Erik-k/StarJar/README.md

# StarJar
Radiation controlled Christmas lights.

For pictures and a thorough write-up, visit http://knek-tek.me/index.php/2018/01/09/radiation-controlled-christmas-lights/
