Erik-k/StarJar/BOM.xls

Source | H:/StarJar/StarJar.sch
Kicad Rev | Eeschema 4.0.6
Title | Radiation controlled Christmas lights
Company | K'NEK-TEK
Revision | 1.2
Date Issue | November 2017
Reference | Value
U1 | LM555N
J2 | Screw_Terminal_1x02
R10 | 220k
C3 | 1n
D2 | 1N914
R5 | 1k
R4 | 330
R1 | 100k
L1 | 10mH
Q5 | 2N3904
R9 | 15
RV2 | 10-ohm pot
D1 | 1N4937
C2 | 10n, 1kV
R2 | 4.7M
C4 | 220pF, 1kV
C5 | 1uF
RV1 | 500k POT
J3 | Geiger Muller Tube, SBM-20 or SBM-20U
Q4 | 2N3904
R8 | 100k
Q1 | JN3303
C1 | 4.7uF
C6 | 1uF
U2 | LMV321 op-amp
R11 | 15
RV3 | 10-Ohm pot
Q3 | 2N3904
Q2 | 2N3906
R3 | 1k
R6 | 100
R7 | 100
J1 | Micro USB B socket
