Erik-k/StarJar/schematic.pdf

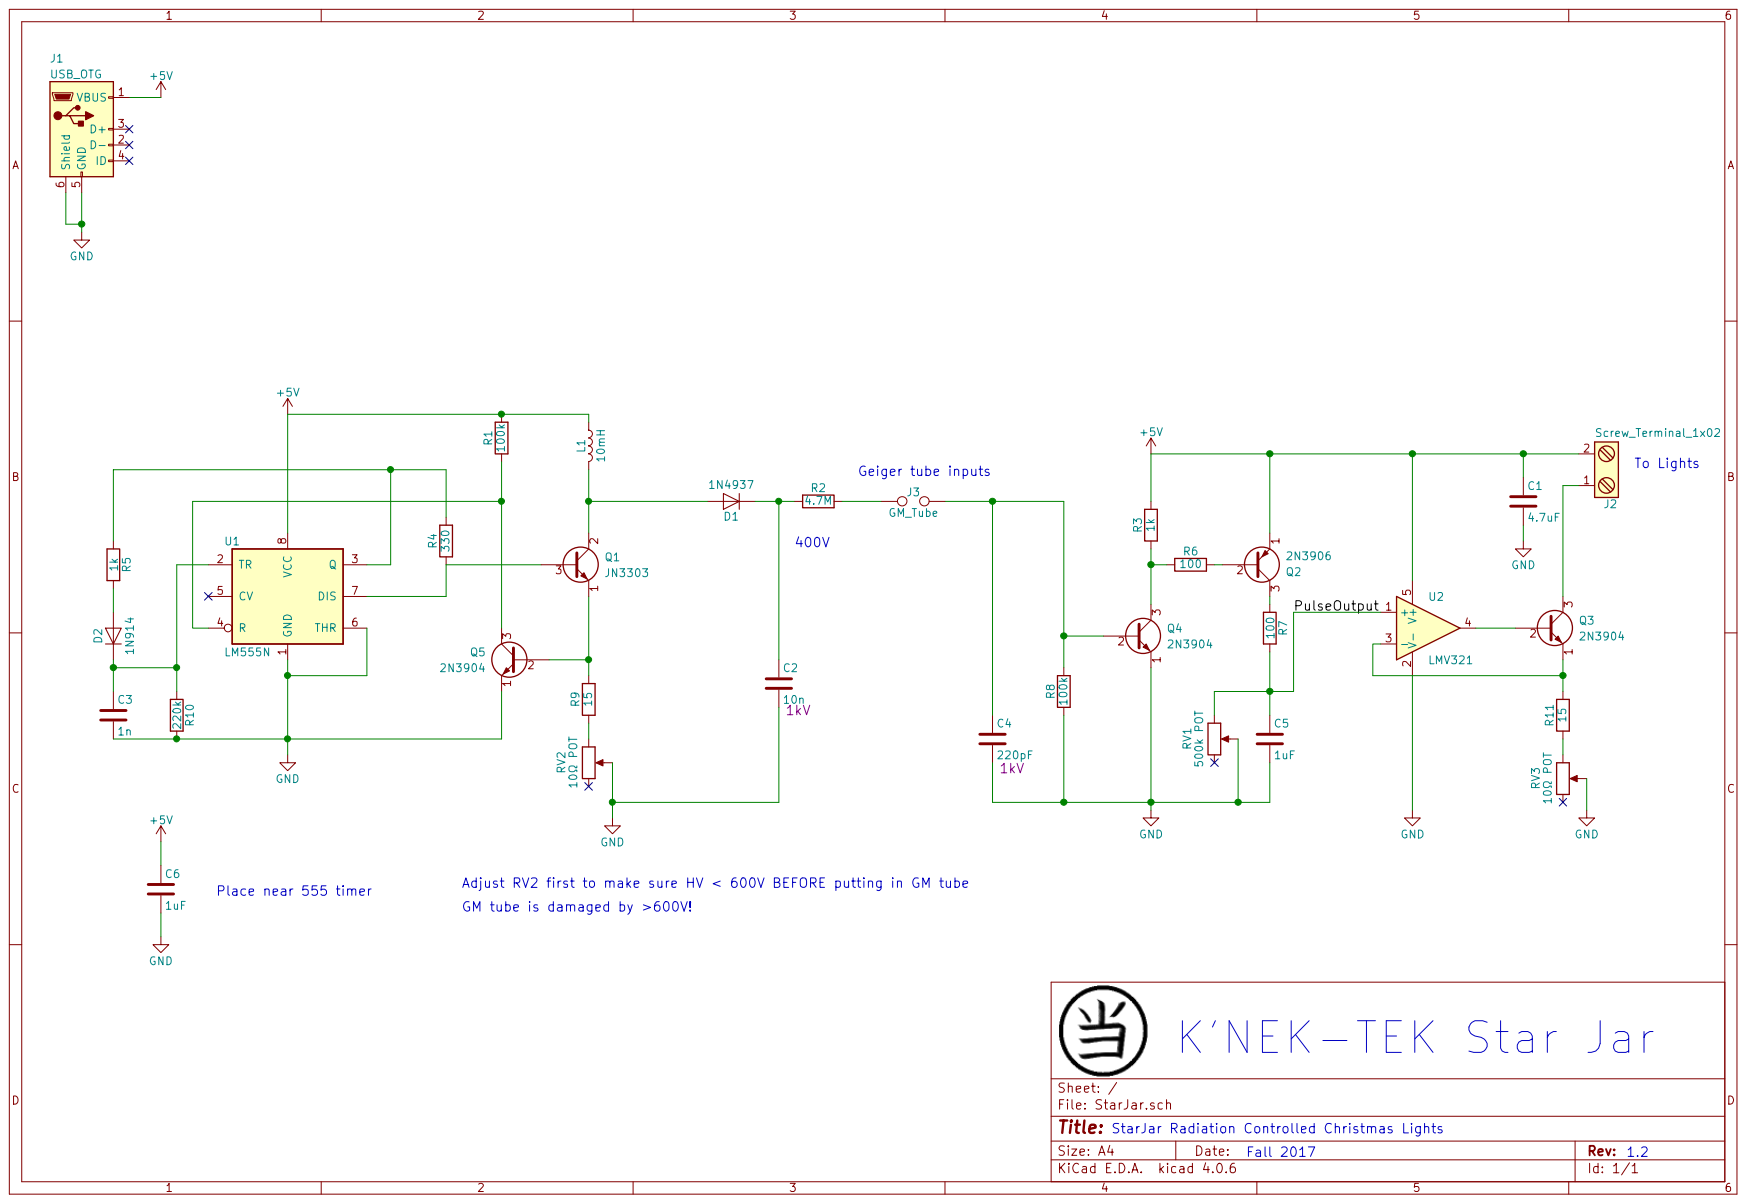
[picture p1: page 1]
