Erik-k/StarJar/PulseTimingCircuit.asc

C1: cap; 1µ; V=10 Irms=2.59 Rser=0.0171188 Lser=0
C2: cap; 220p
Q1: npn; 2N3904
Q2: npn
Q3: pnp; 2N3906
R1: res; 100k
R2: res; 40
R3: res; 1k
R4: res; 10
R5: res; 10
U2: OP747
V1: voltage; PULSE(0 2 0 1m 1m 1n)
V2: voltage; 5
V3: voltage; 2.4; Rser=1
Named nets: 0, pulse_input, Collector, RSense, RC_timer, pnp_base
.tran 10s
