Erik-k/StarJar/StarJar.kicad_pcb

## KiCad design StarJar.kicad_pcb (2017-11-18)

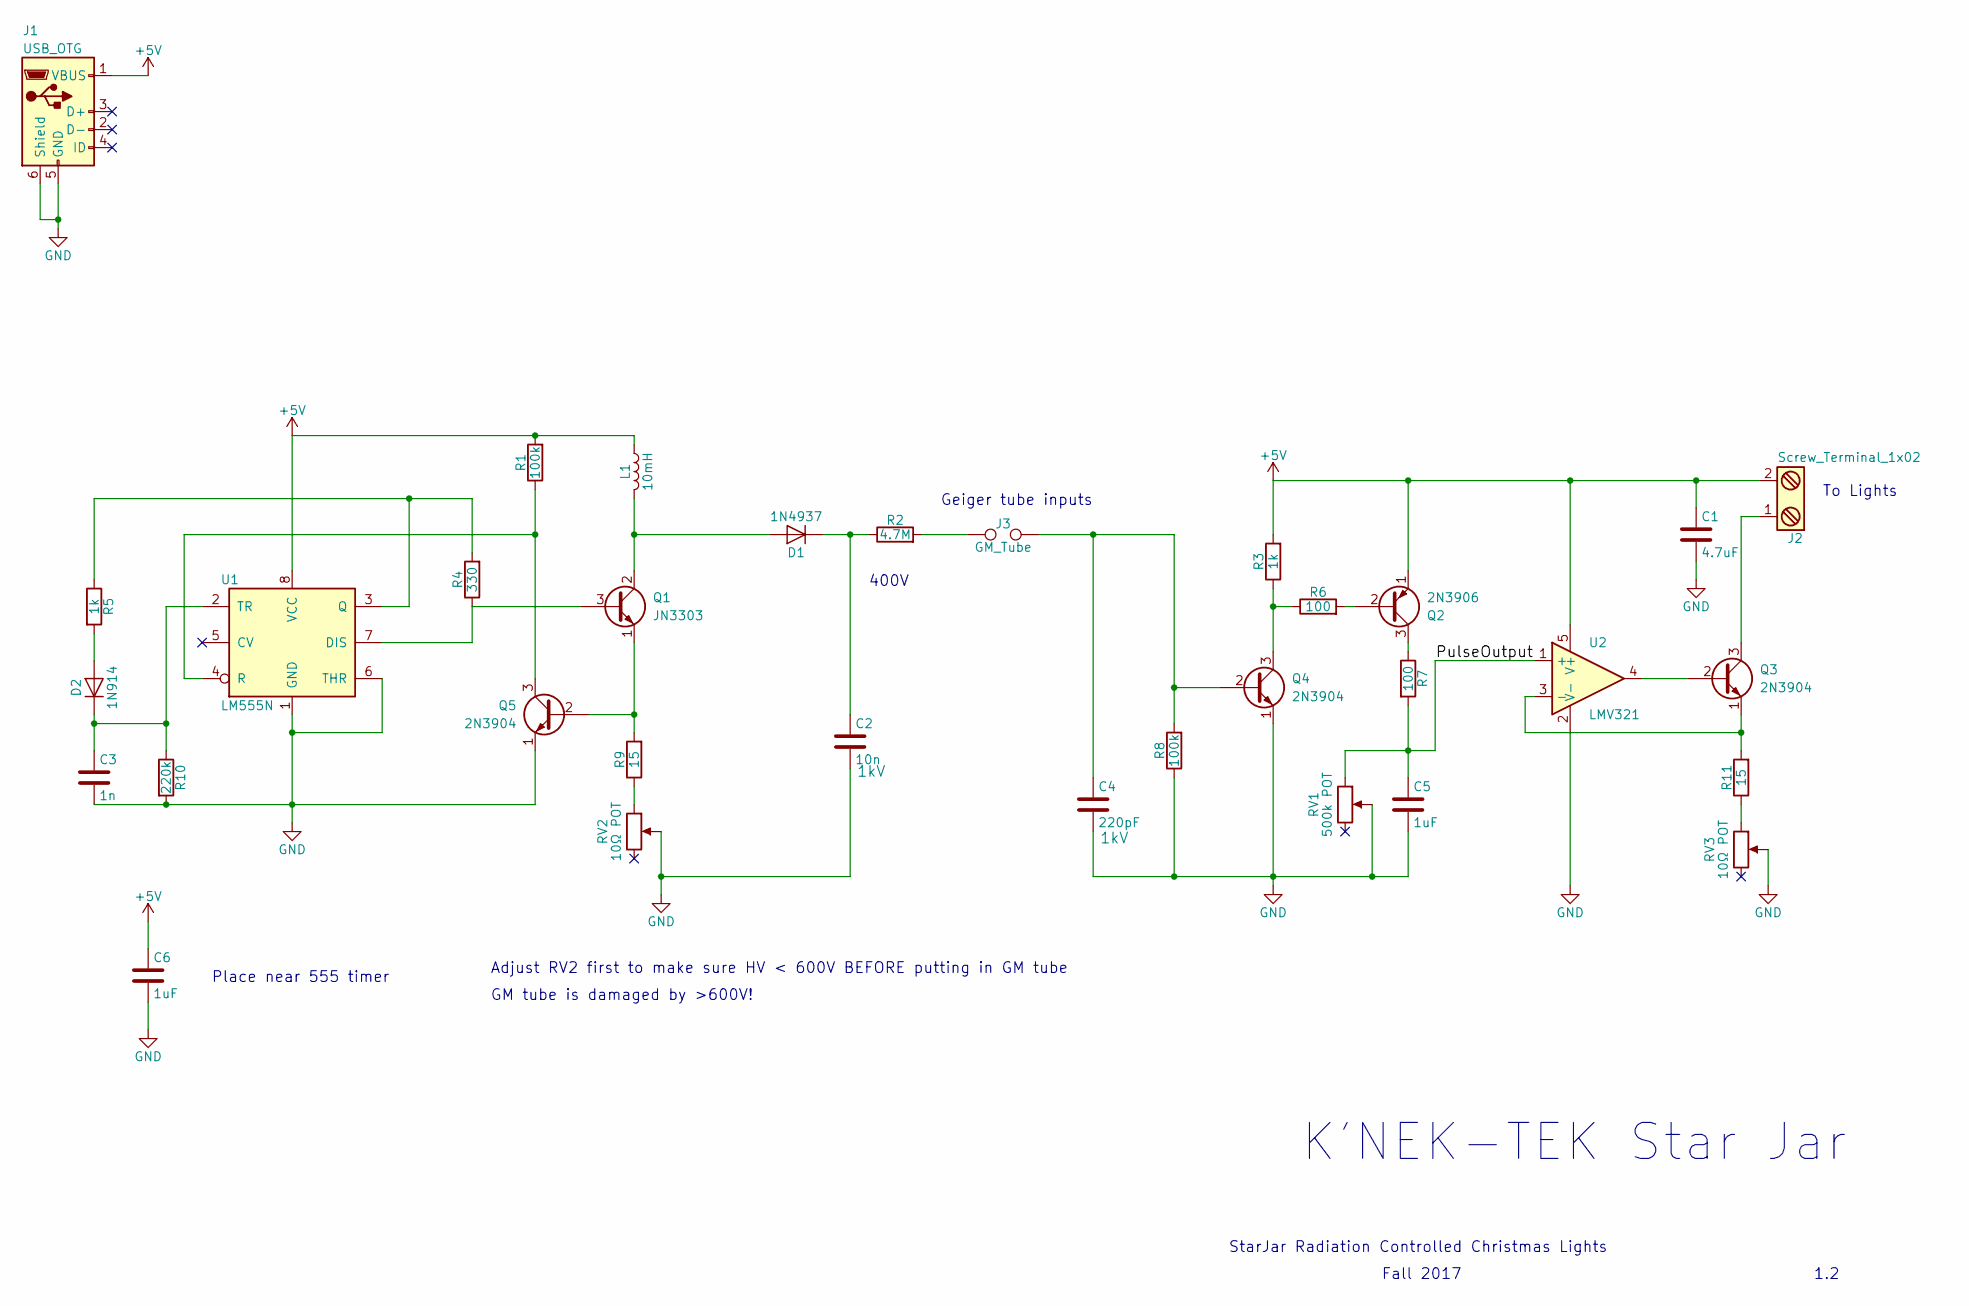
[picture p2: schematic StarJar.sch]

Parts:
C1: 4.7uF; C_1210_HandSoldering
C2: 10n; C_1210_HandSoldering; Voltage 1kV
C3: 1n; C_1210_HandSoldering
C4: 220pF; C_1210_HandSoldering; Voltage 1kV
C5, C6: 1uF; C_1210_HandSoldering
D1: 1N4937; D_DO-41_SOD81_P12.70mm_Horizontal
D2: 1N914; D_DO-41_SOD81_P12.70mm_Horizontal
J1: USB_OTG; USB_Micro-B_big_holes_for_OSHpark
J2: Screw_Terminal_1x02; TerminalBlock_Pheonix_MKDS1.5-2pol
J3: GM_Tube; WireConnection_1.50mmDrill
L1: 10mH; R_Axial_DIN0411_L9.9mm_D3.6mm_P7.62mm_Vertical
Q1: JN3303; TO-92_Inline_Wide
Q2: 2N3906; TO-92_Inline_Wide
Q3, Q4, Q5: 2N3904; TO-92_Inline_Wide
R1, R8: 100k; R_Axial_DIN0411_L9.9mm_D3.6mm_P5.08mm_Vertical
R2: 4.7M; R_Axial_DIN0411_L9.9mm_D3.6mm_P5.08mm_Vertical
R3, R5: 1k; R_Axial_DIN0411_L9.9mm_D3.6mm_P5.08mm_Vertical
R4: 330; R_Axial_DIN0411_L9.9mm_D3.6mm_P5.08mm_Vertical
R6, R7: 100; R_Axial_DIN0411_L9.9mm_D3.6mm_P5.08mm_Vertical
R9, R11: 15; R_Axial_DIN0411_L9.9mm_D3.6mm_P5.08mm_Vertical
R10: 220k; R_Axial_DIN0411_L9.9mm_D3.6mm_P5.08mm_Vertical
RV1: 500k POT; Potentiometer_Trimmer_Suntan_TSR-3386P_Horizontal
RV2, RV3: 10Ω POT; Potentiometer_Trimmer_Suntan_TSR-3386P_Horizontal
U1: LM555N; DIP-8_W7.62mm_Socket
U2: LMV321; SOT-23-5_HandSoldering

Connections:
+5V: C1.1, C6.1, J1.1 (VBUS), J2.2, L1.1, Q2.1 (E), R1.2, R3.2, U1.8 (VCC), U2.5 (V+)
/PulseOutput: C5.1, R7.2, RV1.1, U2.1 (+)
GND: C1.2, C2.2, C3.2, C4.2, C5.2, C6.2, J1.5 (GND), J1.6 (Shield), Q4.1 (E), Q5.1 (E), R8.1, R10.2, RV1.2, RV2.2, RV3.2, U1.1 (GND), U1.6 (THR), U2.2 (V-)
unnamed: C2.1, D1.1 (K), R2.1
unnamed: C3.1, D2.1 (K), R10.1, U1.2 (TR)
unnamed: C4.1, J3.2, Q4.2 (B), R8.2
unnamed: D1.2 (A), L1.2, Q1.2 (C)
unnamed: D2.2 (A), R5.2
unnamed: J2.1, Q3.3 (C)
unnamed: J3.1, R2.2
unnamed: Q1.1 (E), Q5.2 (B), R9.2
unnamed: Q1.3 (B), R4.1, U1.7 (DIS)
unnamed: Q2.2 (B), R6.2
unnamed: Q2.3 (C), R7.1
unnamed: Q3.1 (E), R11.2, U2.3 (-)
unnamed: Q3.2 (B), U2.4
unnamed: Q4.3 (C), R3.1, R6.1
unnamed: Q5.3 (C), R1.1, U1.4 (R)
unnamed: R4.2, R5.1, U1.3 (Q)
unnamed: R9.1, RV2.1
unnamed: R11.1, RV3.1

Notes on the sheet:
StarJar Radiation Controlled Christmas Lights
Fall 2017
1.2
Geiger tube inputs
400V
To Lights
Place near 555 timer
Adjust RV2 first to make sure HV < 600V BEFORE putting in GM tube
GM tube is damaged by >600V!
K'NEK-TEK Star Jar

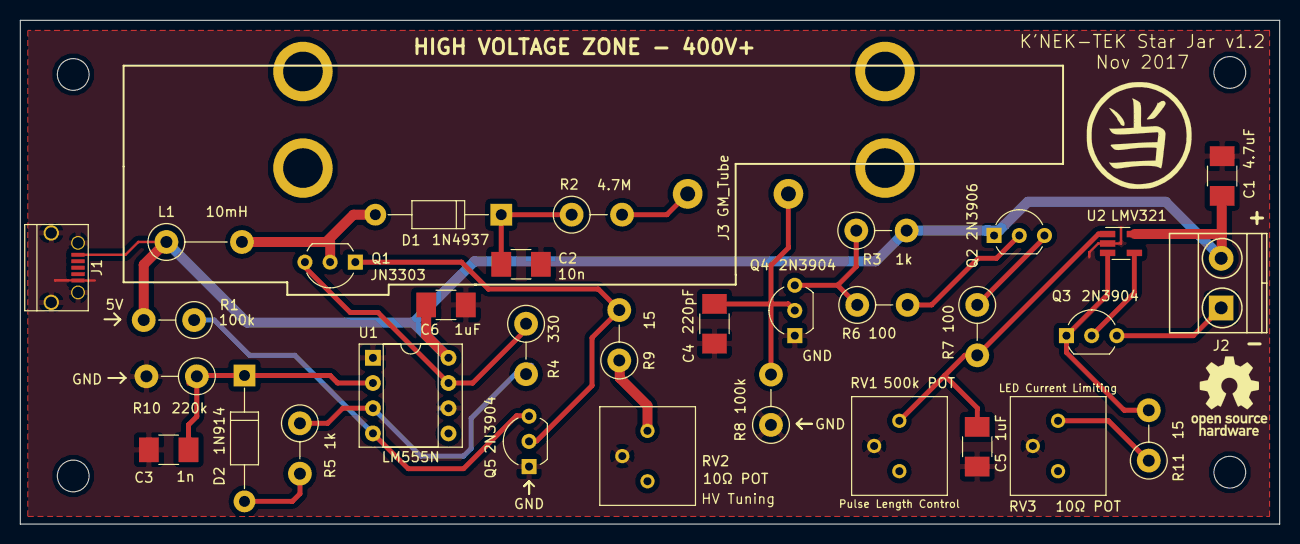
[picture p3: board StarJar.kicad_pcb from above]

Board: 2 copper layers, 127.0 x 50.8 mm, 35 parts (0 on the bottom side), 21 nets.

Other parts of the board:
FuseHolder1, FuseHolder1#2: ZipTie; GM_tube_ziptie_mounts
