Erik-k/StarJar/(commit log)

2017-10-17 FirstUpload
    First upload at v1.1. v1.0 not on Github, but I produced the PCBs, populated and tested one, and realized fixes and changes that needed to be made. Specifically the opamp and BJT to do voltage-controlled current-control of the LED string.
    [StarJar.kicad_pcb, StarJar.sch]
2017-10-18 Add files via upload
    v1.1 routing done and ready to order
    [StarJar.kicad_pcb, StarJar.sch]
2017-10-27 Add files via upload
    PCB ordered from OSH Park. I realized I should use zip ties rather than fuse holders for the SBM-20/U GM tube.
    [StarJar.kicad_pcb]
2017-11-17 Add files via upload
    v1.2 board layout finished, ready to order. Changes: zip tie mounts for GM tube, USB micro-B rather than USB-A, added new components to fix pulse size issue.
    [2017-11-15T19-04-33.csv, StarJar.kicad_pcb, StarJar.sch]
2017-11-18 Add files via upload
    Minor changes to PCB silkscreen. Ordered the boards.
    [StarJar.kicad_pcb]
2017-12-01 Final BOM.
    [BOM.xls]
